vipaoL/xiaomi-pipa-diy-pogo-keyboard/firmware/src/keycodes.h

#ifndef KEYS_H
#define KEYS_H

#define K_A          0x04
#define K_B          0x05
#define K_C          0x06
#define K_D          0x07
#define K_E          0x08
#define K_F          0x09
#define K_G          0x0A
#define K_H          0x0B
#define K_I          0x0C
#define K_J          0x0D
#define K_K          0x0E
#define K_L          0x0F
#define K_M          0x10
#define K_N          0x11
#define K_O          0x12
#define K_P          0x13
#define K_Q          0x14
#define K_R          0x15
#define K_S          0x16
#define K_T          0x17
#define K_U          0x18
#define K_V          0x19
#define K_W          0x1A
#define K_X          0x1B
#define K_Y          0x1C
#define K_Z          0x1D

#define K_1          0x1E
#define K_2          0x1F
#define K_3          0x20
#define K_4          0x21
#define K_5          0x22
#define K_6          0x23
#define K_7          0x24
#define K_8          0x25
#define K_9          0x26
#define K_0          0x27

#define K_ENT        0x28
#define K_ESC        0x29
#define K_BKSP       0x2A
#define K_TAB        0x2B
#define K_SPC        0x2C
#define K_MINUS      0x2D
#define K_EQUAL      0x2E
#define K_LBRC       0x2F
#define K_RBRC       0x30
#define K_BSLS       0x31
#define K_SCLN       0x33
#define K_QUOT       0x34
#define K_GRAVE      0x35
#define K_COMM       0x36
#define K_DOT        0x37
#define K_SLSH       0x38
#define K_CAPS       0x39

#define K_F1         0x3A
#define K_F2         0x3B
#define K_F3         0x3C
#define K_F4         0x3D
#define K_F5         0x3E
#define K_F6         0x3F
#define K_F7         0x40
#define K_F8         0x41
#define K_F9         0x42
#define K_F10        0x43
#define K_F11        0x44
#define K_F12        0x45

#define K_PRTSC      0x46
#define K_SCRL       0x47
#define K_PAUS       0x48
#define K_INS        0x49
#define K_HOME       0x4A
#define K_PGUP       0x4B
#define K_DEL        0x4C
#define K_END        0x4D
#define K_PGDN       0x4E
#define K_RGHT       0x4F
#define K_LEFT       0x50
#define K_DOWN       0x51
#define K_UP         0x52
#define K_APP        0x65

#define K_F13        0x68
#define K_F14        0x69
#define K_F15        0x6A
#define K_F16        0x6B

#define K_MUTE       0x7F
#define K_VOL_UP     0x80
#define K_VOL_DN     0x81

#define K_NUM_SLASH  0x54
#define K_NUM_AST    0x55
#define K_NUM_MINUS  0x56
#define K_NUM_PLUS   0x57

#define K_NUMLK      0x53
#define K_NUM_SLASH  0x54
#define K_NUM_AST    0x55
#define K_NUM_MINUS  0x56
#define K_NUM_PLUS   0x57
#define K_NUM_1      0x59
#define K_NUM_2      0x5A
#define K_NUM_3      0x5B
#define K_NUM_4      0x5C
#define K_NUM_5      0x5D
#define K_NUM_6      0x5E
#define K_NUM_7      0x5F
#define K_NUM_8      0x60
#define K_NUM_9      0x61
#define K_NUM_0      0x62
#define K_NUM_DOT    0x63
#define K_BR_UP      0x6F
#define K_BR_DN      0x70
#define K_MUTE       0x7F
#define K_VOL_UP     0x80
#define K_VOL_DN     0x81

#define K_LCTRL      0xE0
#define K_LSHIFT     0xE1
#define K_LALT       0xE2
#define K_LMETA      0xE3
#define K_RCTRL      0xE4
#define K_RSHIFT     0xE5
#define K_RALT       0xE6
#define K_RMETA      0xE7

#define K_TEST       0xFD
#define MCU_RST      0xFE
#define K_FN         0xFF

#endif
