vipaoL/xiaomi-pipa-diy-pogo-keyboard/firmware/src/layout.h

#include "keycodes.h"
#include "config.h"

#ifndef LAYOUT_H
#define LAYOUT_H

/*
* Layer BASE
* ,-----------------------------------------------------------------------------------------.
* | Esc | ` | F1 | F2 | F3 | F4 | F5 | F6 | F7 | F8 | F9 | F10 | F11 | F12 | PS | Ins | Del |
* |-----------------------------------------------------------------------------------------.
* |  1  |  2  |  3  |  4  |  5  |  6  |  7  |  8  |  9  |  0  |   -   |   =   |     Bksp    |
* |-----------------------------------------------------------------------------------------+
* | Tab    |  q  |  w  |  e  |  r  |  t  |  y  |  u  |  i  |  o  |  p  |  [  |  ]  |   \    |
* |-----------------------------------------------------------------------------------------+
* | Caps    |  a  |  s  |  d  |  f  |  g  |  h  |  j  |  k  |  l  |  ;  |  '  |    Enter    |
* |-----------------------------------------------------------------------------------------+
* | Shift      |  z  |  x  |  c  |  v  |  b  |  n  |  m  |  ,  |  .  |   /   |  UP  | Shift |
* |-----------------------------------------------------------------------------------------+
* | Ctrl  |  FN  | LGUI  | Alt |         space          | Alt | Menu |  LEFT | DOWN | RIGHT |
* \-----------------------------------------------------------------------------------------/
  */

/*
* Layer FN
* ,-----------------------------------------------------------------------------------------.
* |     |   |zzZ | Rf |BrUp|BrDn|aaa*|bbb*|Mute|VlDn|VlUp|     |NumLk|ScrLk|    |PrtSc|SysRq|
* |-----------------------------------------------------------------------------------------.
* |     |     |     |     |     |     |  7  |  8  |  9  |  /  |       |       |             |
* |-----------------------------------------------------------------------------------------+
* |        |     |     |     |     |     |     |  4  |  5  |  6  |  *  |     |     |        |
* |-----------------------------------------------------------------------------------------+
* |         |     |     |     |     |     |     |  1  |  2  |  3  |  -  |     |             |
* |-----------------------------------------------------------------------------------------+
* |            |     |     |     |     |     |     |  0  |  ,  | .,  |   +   | PgUp |       |
* |-----------------------------------------------------------------------------------------+
* |       |      |       |     |                        |     |      |  Home | PgDn |  End  |
* \-----------------------------------------------------------------------------------------/
* aaa* - toggle monitors
* bbb* - task manager
  */

/* Matrix layout
* 	B0	A7	A6	A5	B8	A3	B4	A2	A0	B11	B14	B9	B6	B3	A8	A1
* B1	Esc	F1	F3	F5	F7	F9	F11	PausBr	Ins							
* B10	~	F2	F4	F6	F8	F10	F12		Del							
* B12	1	3	5	7	8	0	=		Bcksp	Tab						
* B13	2	4	6	U	9	-	[	Up	\	Q	Caps	RSh				
* B15	W	E	T	J	I	P	]	/	Enter	S	A					
* A11	D	R	Y	N	O	;	'	Left	Down							
* B5		F	V		L	,	.	Menu	Right			LShft	LCtrl	LMeta	LAlt	RAlt
* A15	C	G	H	B	K	M	Fn	Space		X	Z					
  */

const uint8_t KEYMAP[8][16] = {
    {K_ESC,   K_F1,   K_F3,   K_F5,    K_F7,     K_F9,        K_F11,     K_PAUS,       K_INS,   0,      0,      0,      0,      0,      0,      0},
    {K_GRAVE, K_F2,   K_F4,   K_F6,    K_F8,     K_F10,       K_F12,     0,            K_DEL,   0,      0,      0,      0,      0,      0,      0},
    {K_1,     K_3,    K_5,    K_7,     K_8,      K_0,         K_EQUAL,   0,            K_BKSP,  K_TAB,  0,      0,      0,      0,      0,      0},
    {K_2,     K_4,    K_6,    K_U,     K_9,      K_MINUS,     K_LBRC,    K_UP,         K_BSLS,  K_Q,    K_CAPS, K_RSHIFT,0,     0,      0,      0},
    {K_W,     K_E,    K_T,    K_J,     K_I,      K_P,         K_RBRC,    K_SLSH,       K_ENT,   K_S,    K_A,    0,      0,      0,      0,      0},
    {K_D,     K_R,    K_Y,    K_N,     K_O,      K_SCLN,      K_QUOT,    K_LEFT,       K_DOWN,  0,      0,      0,      0,      0,      0,      0},
    {0,       K_F,    K_V,    0,       K_L,      K_COMM,      K_DOT,     K_APP,        K_RGHT,  0,      0,      K_LSHIFT,K_LCTRL,K_LMETA,K_LALT,K_RALT},
    {K_C,     K_G,    K_H,    K_B,     K_K,      K_M,         K_FN,      K_SPC,        0,       K_X,    K_Z,    0,      0,      0,      0,      0},
};

const uint8_t FN_KEYMAP[8][16] = {
    {MCU_RST, K_F13,  K_BR_UP, K_F15,   K_MUTE,   K_VOL_UP,    K_NUMLK,   0,            K_PRTSC, 0,      0,      0,      0,      0,      0,      0},
    {0,       K_F14,  K_BR_DN, K_F16,   K_VOL_DN, 0,           K_SCRL,    0,            K_PRTSC, 0,      0,      0,      0,      0,      0,      0},
    {0,       0,      0,       K_NUM_7, K_NUM_8,  K_NUM_SLASH, 0,         0,            0,       0,      0,      0,      0,      0,      0,      0},
    {0,       0,      0,       K_NUM_4, K_NUM_9,  0,           0,         K_PGUP,       0,       0,      0,      0,      0,      0,      0,      0},
    {0,       0,      K_TEST,  K_NUM_1, K_NUM_5,  K_NUM_AST,   0,         K_NUM_PLUS,   0,       0,      0,      0,      0,      0,      0,      0},
    {0,       0,      0,       0,       K_NUM_6,  K_NUM_MINUS, 0,         K_HOME,       K_PGDN,  0,      0,      0,      0,      0,      0,      0},
    {0,       0,      0,       0,       K_NUM_3,  K_NUM_DOT,   K_NUM_DOT, 0,            K_END,   0,      0,      0,      0,      0,      0,      0},
    {0,       0,      0,       0,       K_NUM_2,  K_NUM_0,     0,         0,            0,       0,      0,      0,      0,      0,      0,      0},
};

#endif
