vipaoL/xiaomi-pipa-diy-pogo-keyboard/firmware/src/display.cpp

#include "display.h"

Adafruit_SSD1306 display(SCREEN_WIDTH, SCREEN_HEIGHT, &Wire, OLED_RESET);

void initDisplay() {
  Wire.begin(OLED_SDA, OLED_SCL);
  Wire.setClock(400000);

  if(!display.begin(SSD1306_SWITCHCAPVCC, SCREEN_ADDRESS)) {
    // no display
  } else {
    display.setRotation(2);
    display.clearDisplay();
    display.setTextSize(1);
    display.setTextColor(SSD1306_WHITE);
    display.setCursor(0, 0);
    display.println("_");
    display.setCursor(0, 0);
    display.display();
  }
}
