vipaoL/xiaomi-pipa-diy-pogo-keyboard/(commit log)

2026-05-22 change ststm32 platform to my fork with stm32l051c8 support
2026-05-22 fixup! initial commit
    [pipa-kb.scad]
